linqiugui/Wall-climbing-robot-graduation-project-/爬壁机器人/奖状.jpg

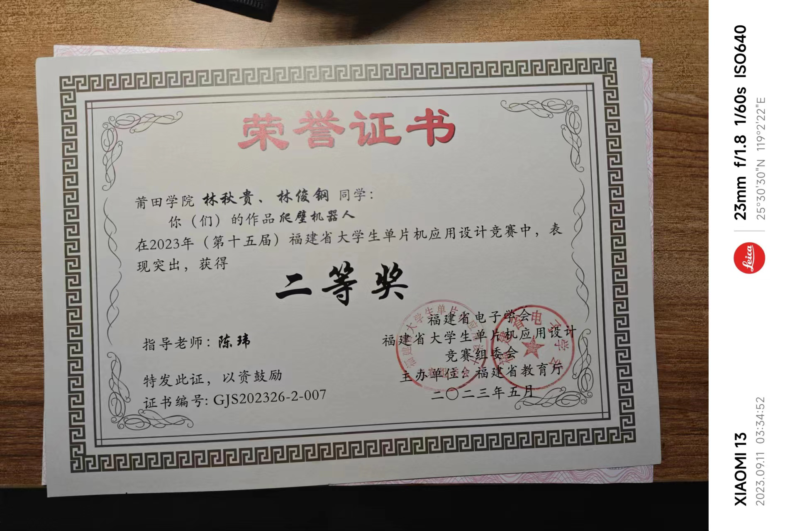
爬壁机器人/奖状.jpg
