linqiugui/Wall-climbing-robot-graduation-project-/爬壁机器人/3D建模/遥控器/10695037_10203569545496849_513445230_n.jpg

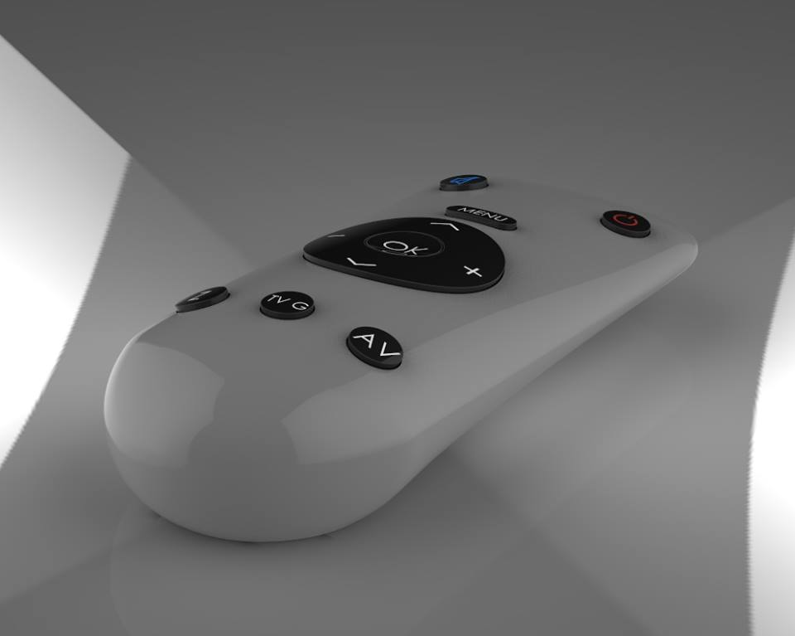
爬壁机器人/3D建模/遥控器/10695037_10203569545496849_513445230_n.jpg
