linqiugui/Wall-climbing-robot-graduation-project-/README.md

# Wall-climbing-robot-graduation-project-
爬壁机器人（毕设）:ht32、openmv h7、图像识别、多模式擦拭

作品视频：【2023福建省合泰杯-爬壁机器人】 https://www.bilibili.com/video/BV1Qh4y1n7L4/?share_source=copy_web&vd_source=07c3a1259b6d1e16c98340b300d98cfa
