linqiugui/Wall-climbing-robot-graduation-project-/爬壁机器人/ht32学习/复赛报告/林秋贵-莆田学院-爬壁机器人/林秋贵-莆田学院-爬壁机器人.pdf

(20230115089)：(爬壁机器人)

## 合泰杯单片机应用设计大赛复赛报告 爬壁机器人

学校：莆田学院 学院：机电与信息工程学院
指导老师：陈玮
参赛队员：林秋贵、林俊钢

### E-mail Address:481937578@qq.com 参赛编号:20230115089 使用 HT 单片机型 HT32F52352 日期:2023 年 4 月 25 日

摘要
爬壁机器人在垂直墙壁上攀爬并完成作业的自动化机器人。爬壁机器人又称为壁面移 动机器人，因为垂直壁面作业超出人的极限，因此在国外又称为极限作业机器人。爬壁机器 人必须具备吸附和移动两个基本功能，而常见吸附方式有负压吸附和磁吸附两种。 本作品爬壁机器人的应用场景为擦拭白板，在传统教学模式下，教师擦黑板过程繁琐， 严重影响课堂效率，这种方式会使得粉笔灰吸入教师学生的肺部，引发肺部健康问题。近年 来，因为白板使用时用专门的白板笔，笔杆干净整洁，没有粉渣，可选颜色多，所以黑板转 用白板情况越来越多。此外人为白板擦拭过程中有了一定的工作量，消耗了一部分的教学时 间。针对以上弊端设计了一款基 HT32F52352 的爬壁机器人，通过磁吸附的方式可以稳定地 吸附白板上进行白板擦拭和教学环境检测。
关键词：HT32F52352、爬壁、磁吸附、擦拭、环境检测 一、方案介绍：

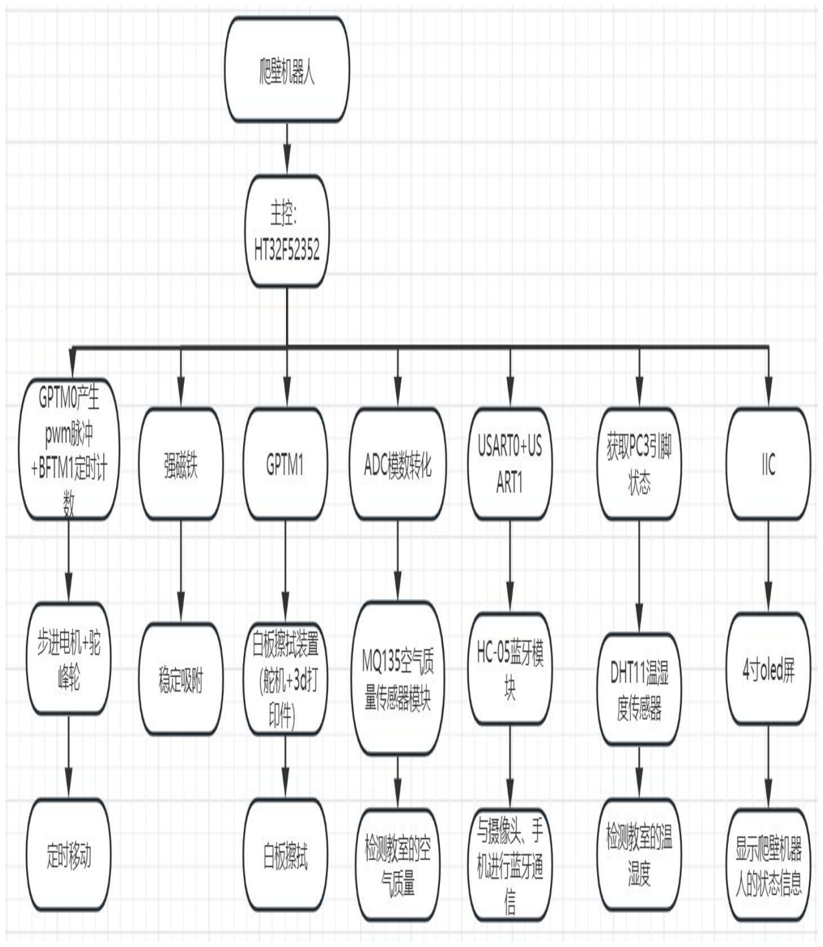
[picture p28: figure]

### 1.1 设计方案

本设计基于 HT32F52352 单片机。爬壁
机器人采用磁吸附的吸附结构置于底部，吸
附结构采用的是强磁铁，相较于电磁铁，强
磁铁磁力不受电压变化影响，使得爬壁机器
人吸力能稳定地吸附在白板上。爬壁机器人
的四个轮子采用驼峰轮，驼峰轮拥有极强的
摩擦力，能够保证爬壁机器人在白板面上移
动轮子不产生打滑。
爬壁机器人的两个 HC-05 蓝牙模块会分
别与来着手机遥控器和摄像头部分的蓝牙模
块进行互联通信。本作品将白板擦拭区域分为
6 个，适应更多不同擦拭区域需求。使用者可
以有三种擦拭模式选择，第一种是按键擦拭，
就是人为到爬壁机器人的屏幕板按下按键自
主控制爬壁机器人移动白板的对应区域进行
擦拭。第二种是无线擦拭，就是人为使用手机
控制爬壁机器人移动白板的某个区域进行擦
拭。第三种是智能擦拭，由摄像头 OPENMV
H7 智能识别白板需要擦拭的位置区域，用蓝
牙通信的方式传递给爬壁机器人，然后爬壁机
器人移动到指定位置进行擦拭，适应更多不同
擦拭方式需求。
在爬壁机器人一上电的瞬间，DHT11 温
湿度传感器和 MQ135 空气质量传感器模块也
会上电工作，检测环境中的温湿度、空气质量，
并将环境检测数据进行输出实时显示在爬壁
机器人的 OLED 屏幕上。

### 1.2 硬件方块结构图

图 1：硬件结构图

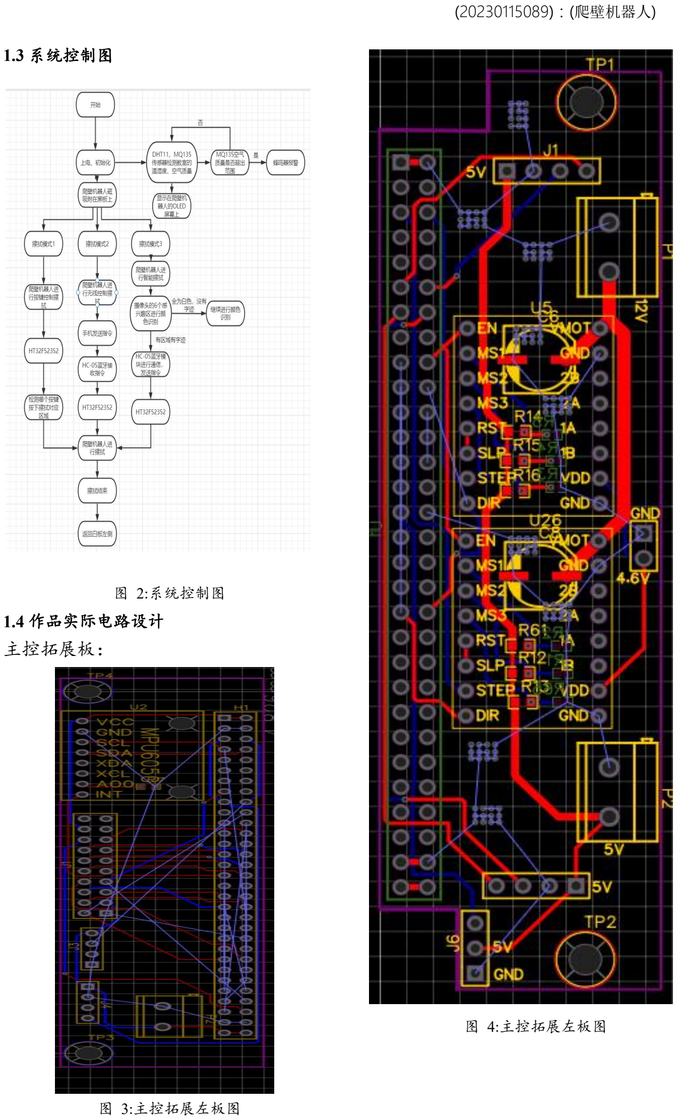
[picture p29: page 2]

### 1.3 系统控制图

图 2:系统控制图

### 1.4 作品实际电路设计

主控拓展板：

图 3:主控拓展左板图

图 4:主控拓展左板图

屏幕板：

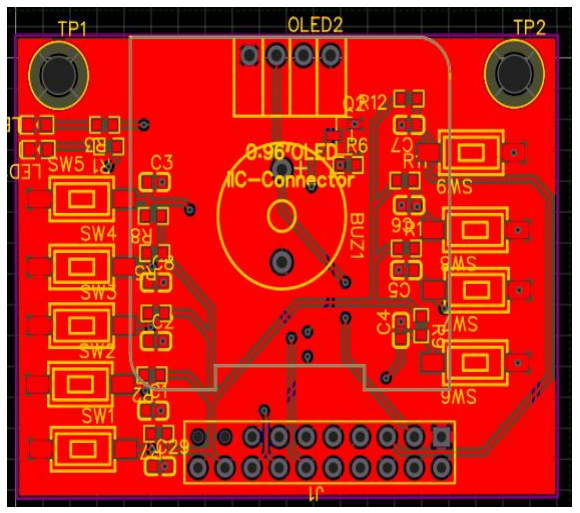
[picture p30: figure]

图 5:屏幕板
电源板：

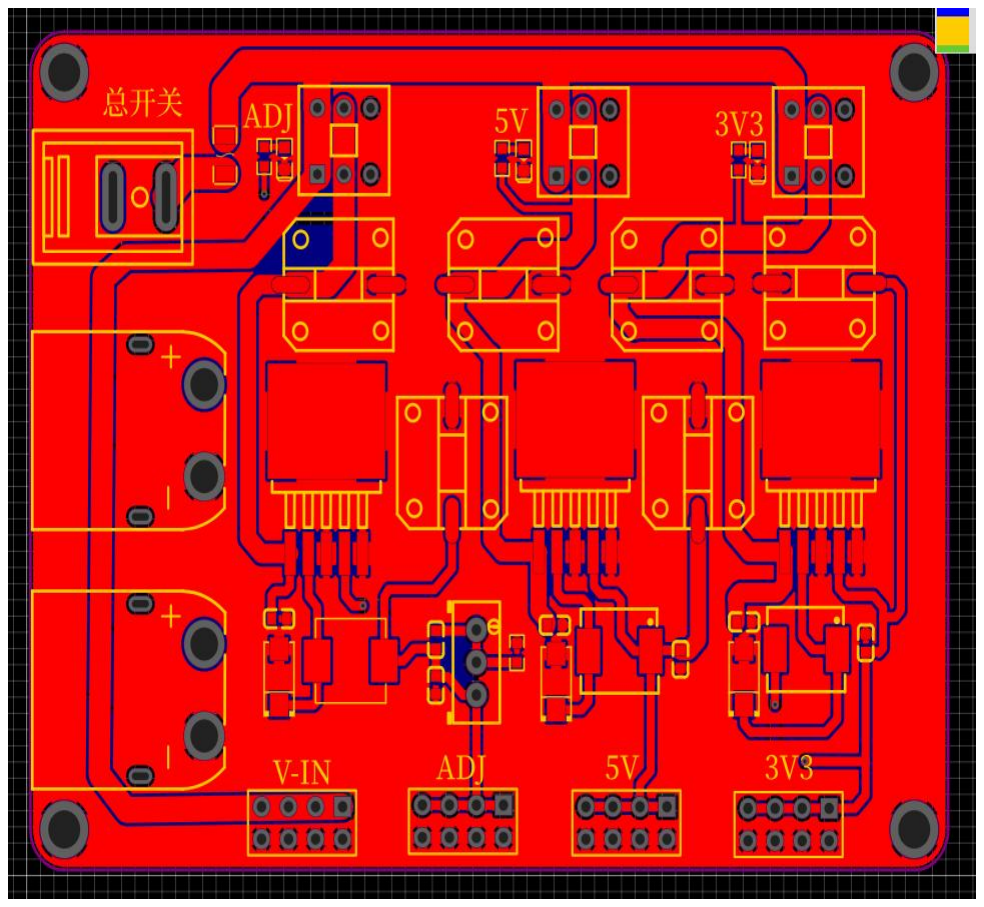
[picture p31: figure]

图 6:电源板
二、工作原理：
本作品基于 HT32F52352 单片机，分
为爬壁机器人部分，摄像头识别部分，手
机遥控器部分。

### 2.1 爬壁机器人部分原理

爬壁机器人主要由白板擦拭装置、强
磁铁、步进电机、驼峰轮、HC-05 蓝牙模
块、DHT11 温湿度传感器、MQ135 空气
质量传感器、oled 屏等组成。
该作品的爬壁机器人采用强磁铁的磁
吸附结构，使得爬壁机器人能吸附在磁性
白板上。爬壁机器人的移动由

### HT32F52352 单片机的通用定时器

（GPTM0）输出 PWM 波产生脉冲驱动步
进电机和基本功能定时器（BFTM1）定时
计数使得爬壁机器人能够进行定时移动。
爬壁机器人的白板擦拭装置由

### MG996-180 度舵机、自主设计的 3D 打印

件、棉布组成，通过 HT32F52352 单片机
的通用定时器（GPTM1）输出 PWM 波使
得舵机一直旋转，白板擦拭装置与白板字
迹产生摩擦,产生擦拭白板的效果。
爬壁机器人通过使用两个HC-05蓝牙
模块和 HT32F52352 单片机的两个串口

### （USART0 和 USART1）与摄像头部分、

手机遥控器部分进行无线蓝牙通信。
该爬壁机器人使用 DHT11 温湿度传
感器模块运用 HT32F52352 的引脚读取电
平信号由 HT32F52352 处理成数据显示在
爬壁机器人的 OLED 屏幕上。该爬壁机器
人使用 MQ-135 空气质量传感器模块运用

### HT32F52352 的 ADC 数模转化，由

HT32F52352 处理成数据显示在爬壁机器
人的 OLED 屏幕上，实时检测环境中的空
气质量、温湿度。

### 2.2 摄像头识别部分原理

摄像头部分主要由摄像头 OPNEMV
H7、HC-05 蓝牙模块、电源板组成。用支
架将摄像头部分放于离白板正前方合适的
位置，便于将整个白板都能进入摄像头的
识别画面中，然后将白板画面分为 6 个感
兴趣区，同时对 6 个感兴趣区进行颜色识
别，当识别有字迹时，摄像头将把有字迹
的感兴趣区的指令通过HC-05蓝牙模块发
给爬壁机器人，例如区域 1 识别到需要擦
拭，摄像头就发出字符‘1’指令给爬壁机
器人，其他区域以此类推。

### 2.3 手机遥控部分原理

手机遥控部分由手机下载蓝牙串口
APP，与爬壁机器人的 HC-05 蓝牙模块进
行互连，通过发送指令无线遥控控制爬壁
机器人对某个区域继续擦拭。

### 2.4 开发内容范围

本作品除部分代码外，其他开发内容
均有参赛者自主开发。
参考代码来源：

### https://blog.csdn.net/boybs/article/details/12446

7960
三、测试方法：

### 3.1 擦拭方法

爬壁机器人分为两部分测试，一部分
为擦拭功能测试，另一部分为摄像头识别
测试。
擦拭功能测试为爬壁机器人是否能够
将对应区域的字迹擦拭干净，擦拭完后能
否移动会白板左侧中央。

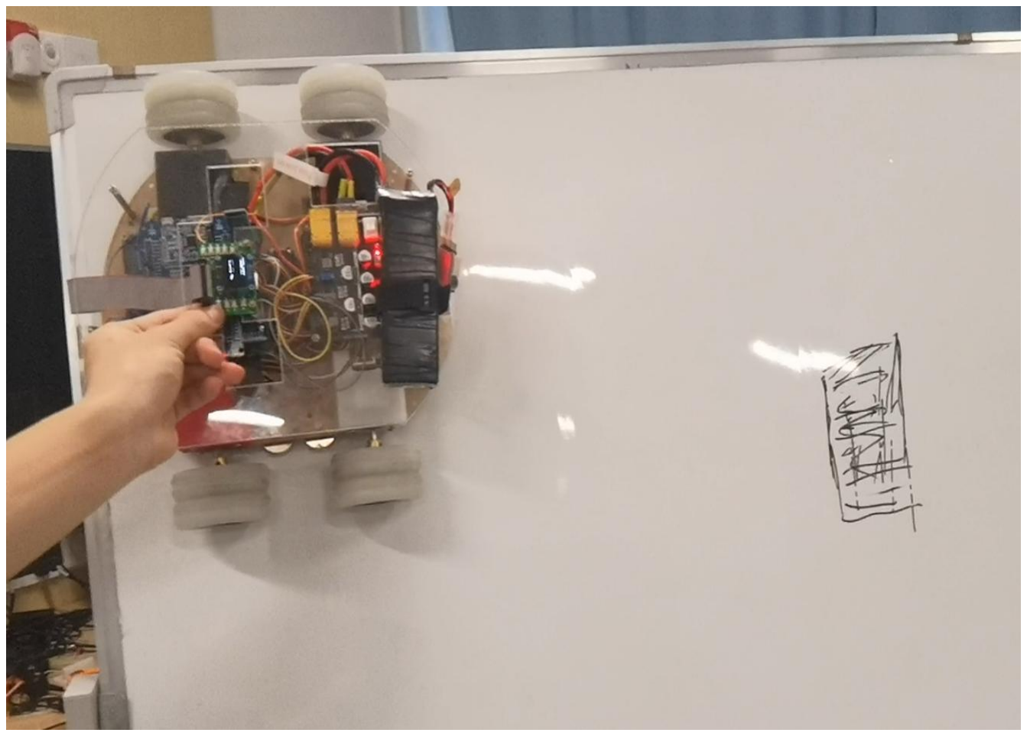
[picture p32: figure]

图 7:擦拭开始前

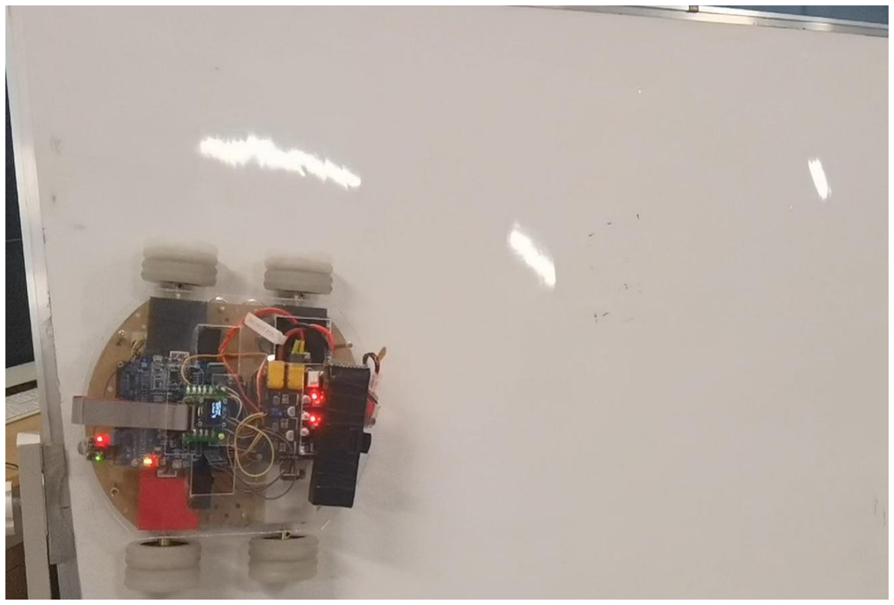
[picture p33: figure]

图 8:字迹擦拭干净，并且回到白板左侧中央
摄像头识别测试为摄像头能否识别出
有字迹的区域，且识别后能否把擦拭指令
发送给爬壁机器人。

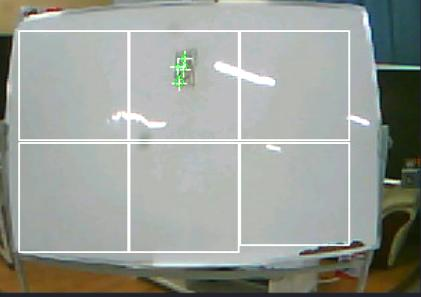
[picture p34: figure]

图 9:摄像头识别出区域 2 字迹

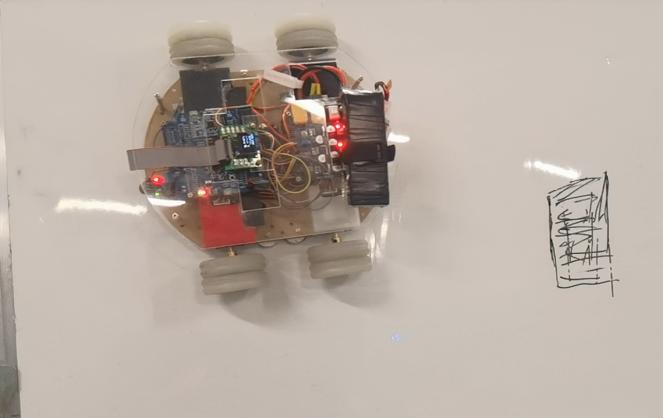
[picture p35: figure]

图 10:爬壁机器人接收到指令，进行擦拭

### 3.2 测试的环境与条件

本作品是基于 HT32F52352 单片机作
为主控芯片。爬壁机器人可以通过三种模
式进行白板擦拭，并且环境中的温湿度、
空气质量实时显示在 oled 屏上。

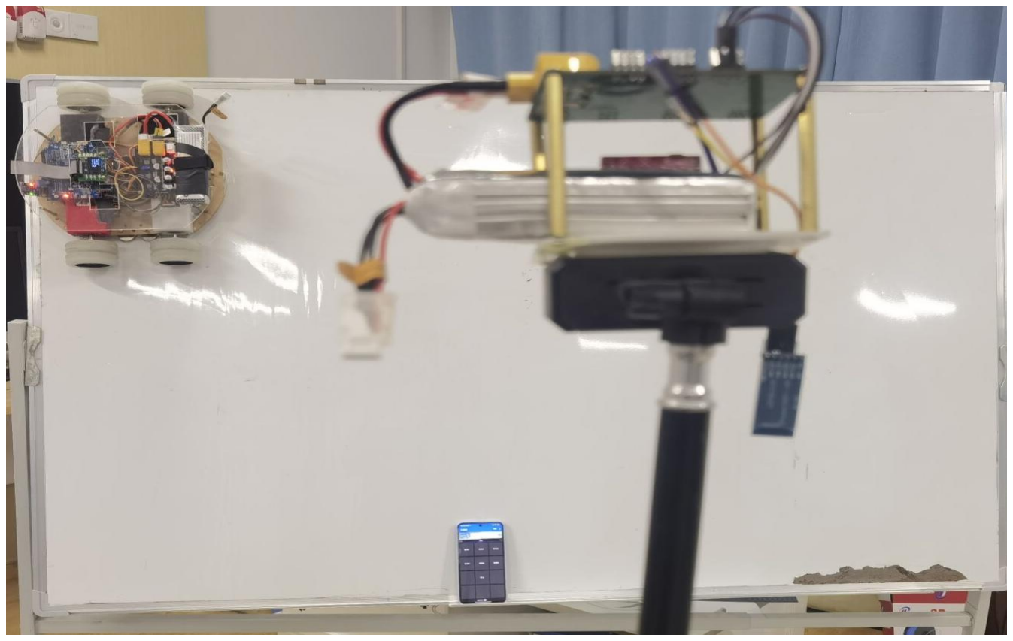
[picture p36: figure]

图 11：整体图

### 3.3 测试结果

本作品各功能均能正常的使用，爬壁
机器人部分和摄像头识别部分、手机遥控
器部分均可通信。但由于经费有限，作品
所使用白板表面不平（中间凹，两侧凸）、
某些区域有凹陷等问题，导致在某个区域
进行擦拭时爬壁机器人移动路线出现偏移、
无法回到白板左侧中央的可能，不影响产
品的擦拭功能正常使用，但测试实验均能
证明模块程序的可行性。
表 1：测试统计表

四、作品结论：

### 4.1 完成情况与应用潜力

作品已完成基本的所有预实现功能，
能够检测环境中的温湿度、空气质量， 较
高概率实现擦拭白板。作品准确率较高，
具有较好的实用价值。该作品能应用于教
学、办公领域的白板擦拭，同类产品较少，
可以填补部分的市场空缺。

### 4.1 未来改进空间

本作品未来可以继续改进，可加入陀

区域 | 测试次数 | 成功次数 | 成功 率
区域 1 | 20 | 19 | 95%
区域 2 | 20 | 18 | 90%
区域 3 | 20 | 12 | 60%
区域 4 | 20 | 18 | 90%
区域 5 | 20 | 16 | 80%
区域 6 | 20 | 14 | 70%

(20230115089)：(爬壁机器人) 螺仪等传感器模块，实现爬壁机器人定向 移动，不受白板表面影响。当经费满足条 件时更将强磁铁的吸附结构改为负压吸附 结构，减少擦拭过程中噪音的产生。 五、参考文献： 【1】吕晓彬，王志凌，梁贵龙，等．基于 STM32 控制器的智能黑板擦系统设计 [J]．盐城工学院学报(自然科学版)，2018， 31（2）：36－37
