linqiugui/Wall-climbing-robot-graduation-project-/爬壁机器人/3D建模/三角架/Phone Tripod.PNG

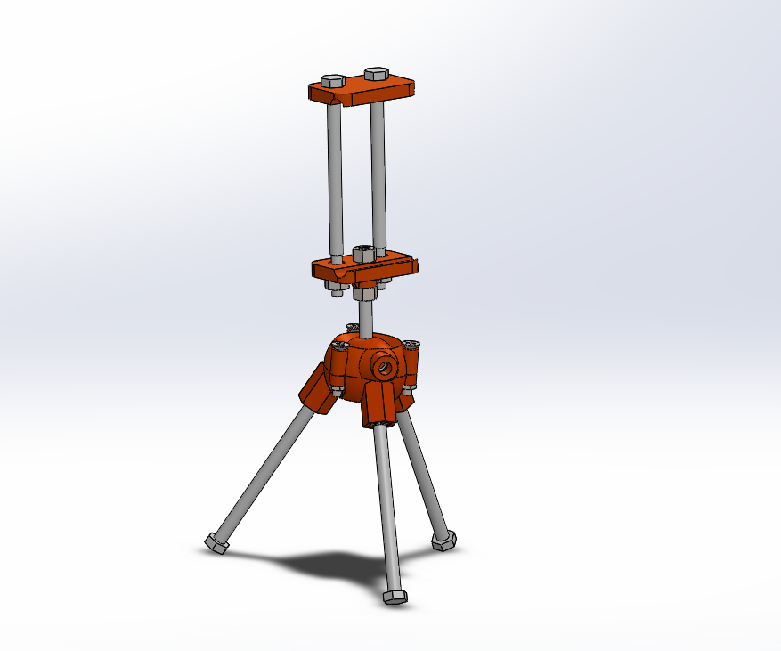
爬壁机器人/3D建模/三角架/Phone Tripod.PNG
