linqiugui/Wall-climbing-robot-graduation-project-/爬壁机器人/3D建模/遥控器/10656420_10203569522256268_1597879605_n.jpg

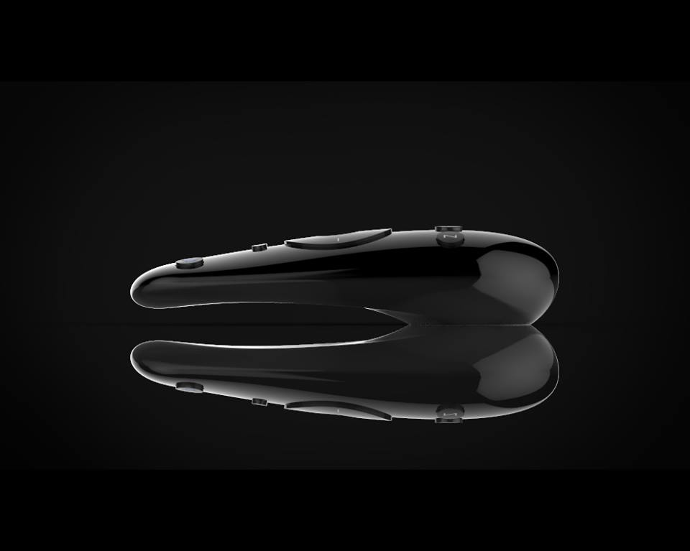
爬壁机器人/3D建模/遥控器/10656420_10203569522256268_1597879605_n.jpg
