linqiugui/Wall-climbing-robot-graduation-project-/爬壁机器人/3D建模/遥控器/10656624_10203569522416272_220578106_n.jpg

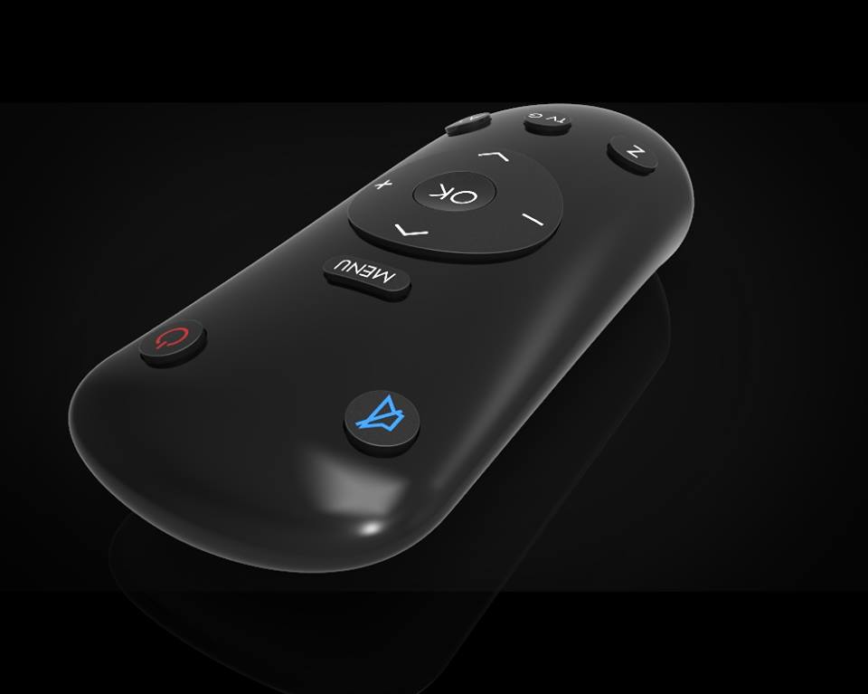
爬壁机器人/3D建模/遥控器/10656624_10203569522416272_220578106_n.jpg
