linqiugui/Wall-climbing-robot-graduation-project-/爬壁机器人/3D建模/遥控器/10668206_10203569545416847_239513707_n.jpg

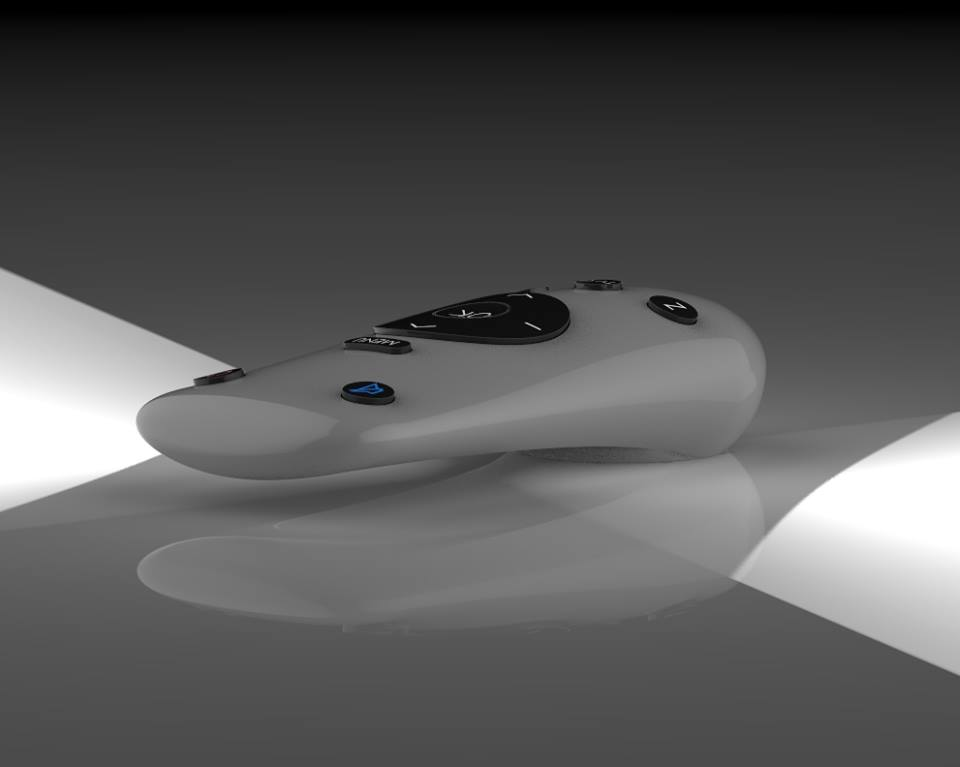
爬壁机器人/3D建模/遥控器/10668206_10203569545416847_239513707_n.jpg
