linqiugui/Wall-climbing-robot-graduation-project-/爬壁机器人/3D建模/遥控器/10682006_10203569522296269_1531062614_n.jpg

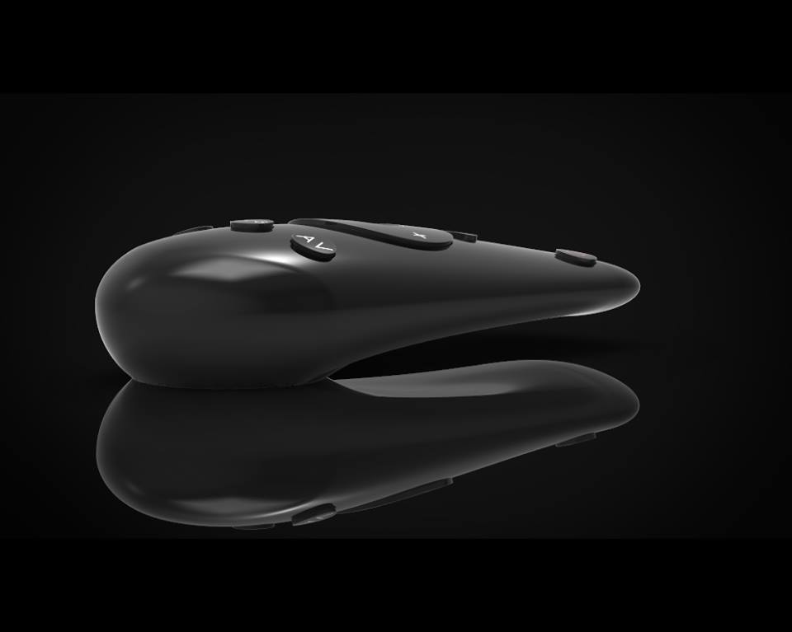
爬壁机器人/3D建模/遥控器/10682006_10203569522296269_1531062614_n.jpg
