linqiugui/Wall-climbing-robot-graduation-project-/爬壁机器人/3D建模/遥控器/10685057_10203569545456848_659820828_n.jpg

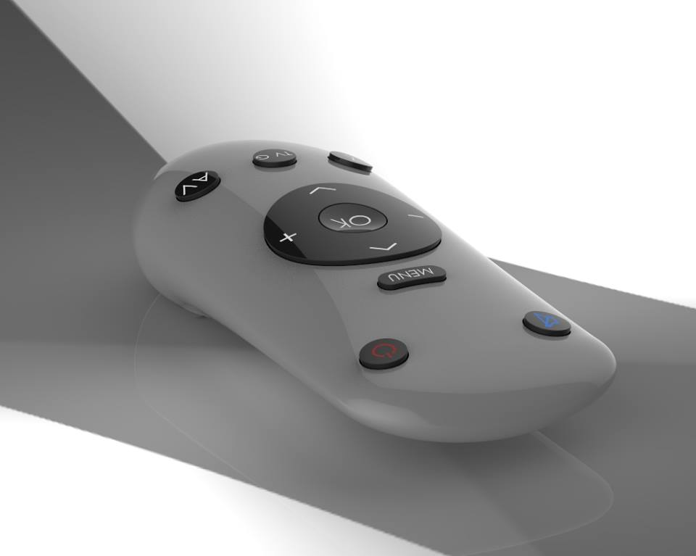
爬壁机器人/3D建模/遥控器/10685057_10203569545456848_659820828_n.jpg
