linqiugui/Wall-climbing-robot-graduation-project-/爬壁机器人/3D建模/遥控器/10695032_10203569522216267_47995985_n (1).jpg

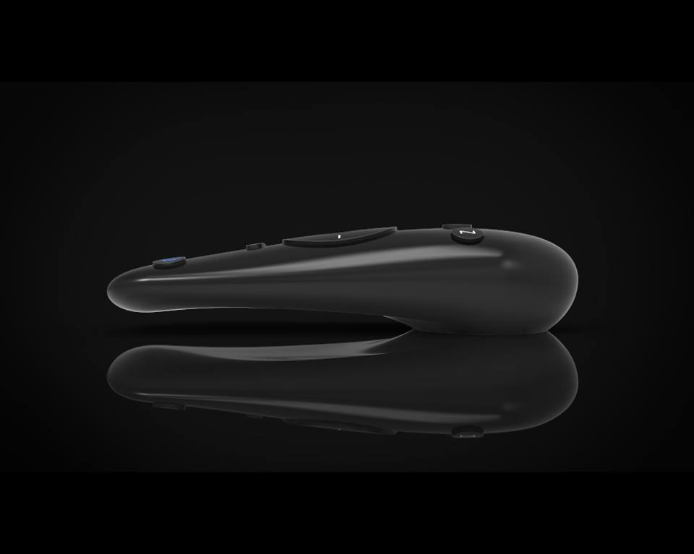
爬壁机器人/3D建模/遥控器/10695032_10203569522216267_47995985_n (1).jpg
