linqiugui/Wall-climbing-robot-graduation-project-/爬壁机器人/3D建模/遥控器/10704995_10203569522176266_1851552461_n.jpg

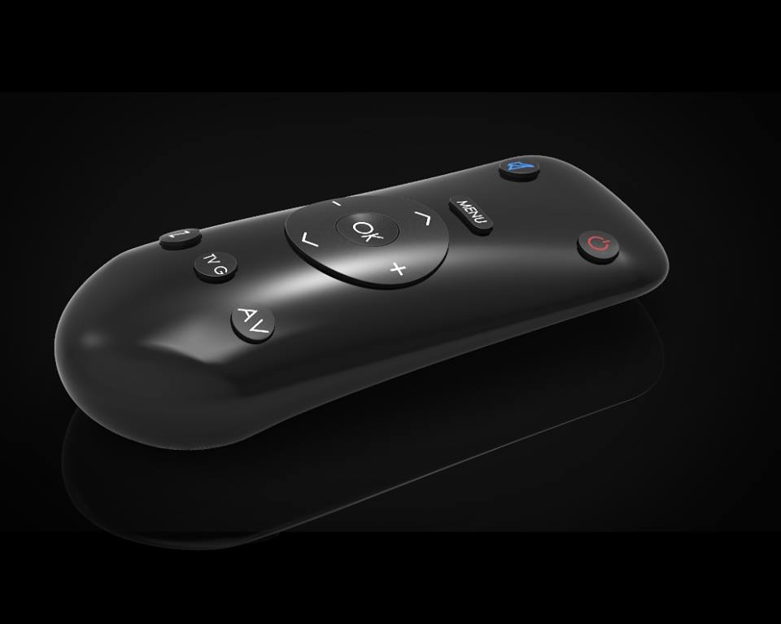
爬壁机器人/3D建模/遥控器/10704995_10203569522176266_1851552461_n.jpg
