linqiugui/Wall-climbing-robot-graduation-project-/爬壁机器人/3D建模/黑板擦小车/A1 麦克纳姆轮（全向轮）四驱agv小车底盘/A.JPG

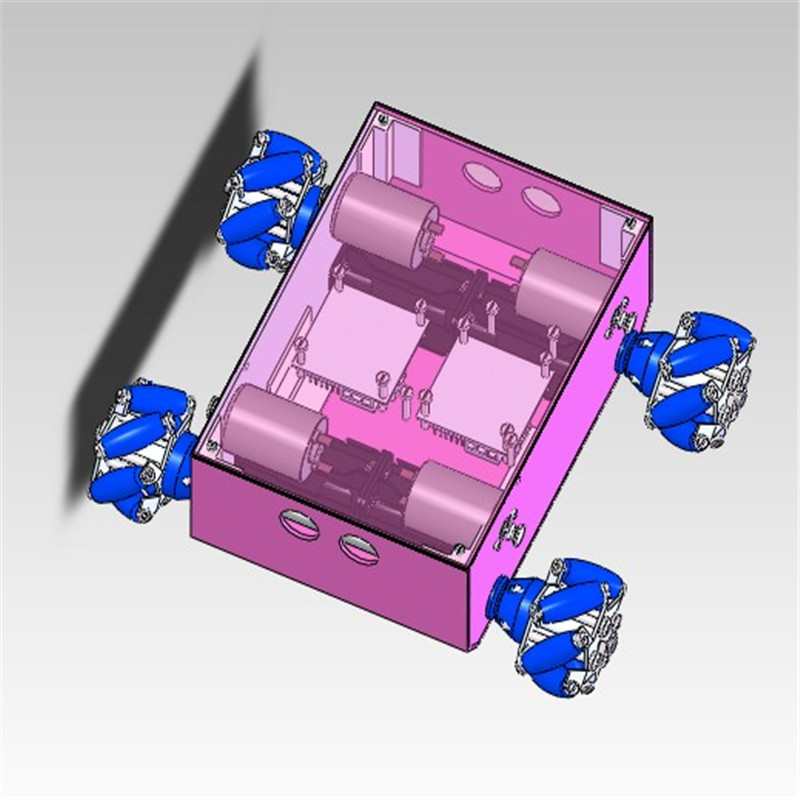
爬壁机器人/3D建模/黑板擦小车/A1 麦克纳姆轮（全向轮）四驱agv小车底盘/A.JPG
