linqiugui/Wall-climbing-robot-graduation-project-/爬壁机器人/ht32学习/林秋贵-莆田学院-爬壁机器人/林秋贵-莆田学院-爬壁机器人-初赛报名简表.xls

2023年第十五届福建省大学生合泰杯单片机应用设计竞赛报名简表
序号 | 参赛编号 | 项目名称 | 指导老师 | 学生身份（本科生或研究生） | 成员一 (队长) | 成员二 | 成员三 | 成员四 | 所在学校 | 联系电话（队长） | QQ
不填 | 不填 | 爬壁机器人 | 陈玮 | 本科生 | 林秋贵 | 林俊钢 |  |  | 莆田学院 | 15059693812 | 481937578
