linqiugui/Wall-climbing-robot-graduation-project-/爬壁机器人/3D建模/三角架/Telefon Bipod.SLDASM

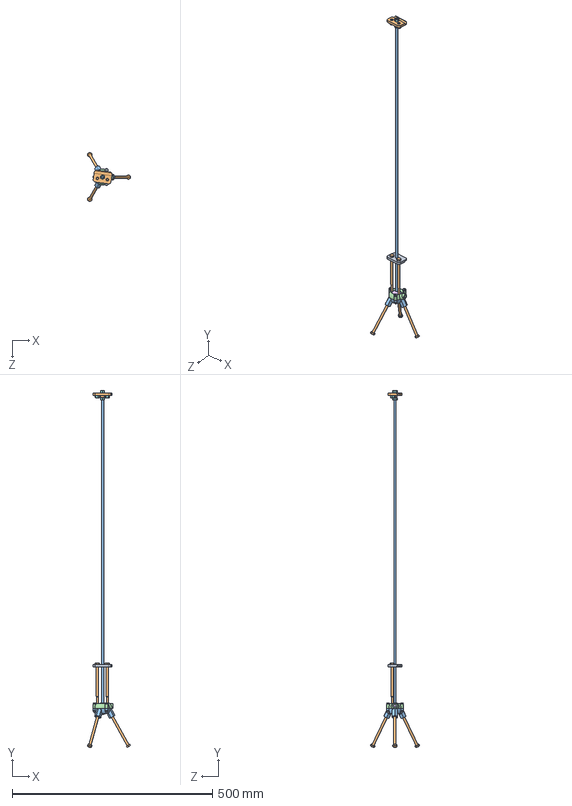
[picture p46: CAD file, 2026-02-27]
爬壁机器人/3D建模/三角架/Telefon Bipod.SLDASM
107.5 x 892.0 x 123.6 mm
hex nut with 1.5d height-2_din x 3
bilya
hex thin nut chamfered gradeab_din x 3
hex nut gradec_din x 4
countersunk flat head cross recess screw_din x 3
M6x100 Civata x 5
M6x60 Civata
