linqiugui/Wall-climbing-robot-graduation-project-/爬壁机器人/3D建模/黑板擦小车/A1 麦克纳姆轮（全向轮）四驱agv小车底盘/麦克纳姆轮（全向轮）四驱agv小车底盘/麦克纳姆轮（全向轮）四驱agv小车底盘/总装配图.SLDASM

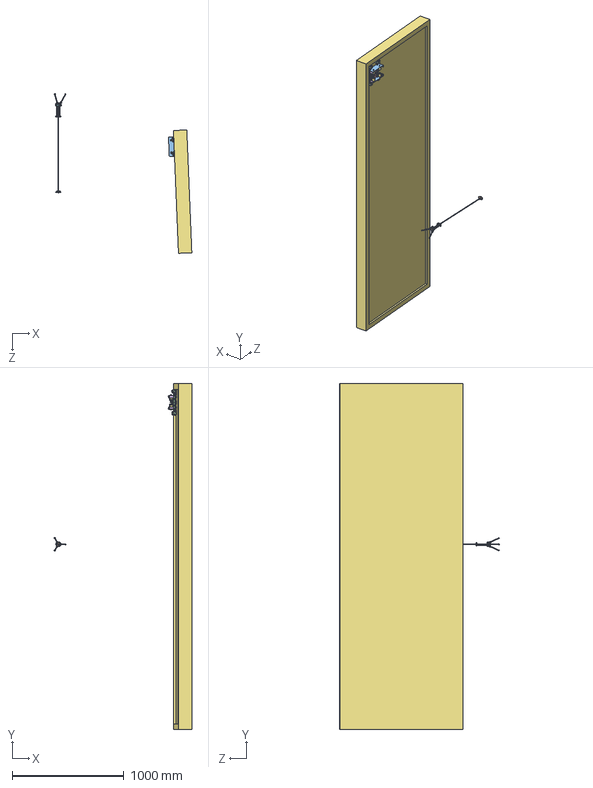
[picture p47: CAD file, 2026-02-27]
爬壁机器人/3D建模/黑板擦小车/A1 麦克纳姆轮（全向轮）四驱agv小车底盘/麦克纳姆轮（全向轮）四驱agv小车底盘/麦克纳姆轮（全向轮）四驱agv小车底盘/总装配图.SLDASM
1234.4 x 3102.2 x 1431.5 mm
Roller2 x 24
Mariposa 1 x 4
Mariposa 2 x 4
nucleo con prisionero x 4
pan head cross recess screw_iso(ISO 7045 - M4 x 40 - Z --- 40N) x 16
slotted cheese head screw_iso(ISO 1207 - M3 x 30 --- 30N) x 24
hex thin nut chamfered gradeab_iso(Hexagon Thin Nut ISO - 4035 - M3 - N) x 24
Pieza lateral x 2
Portapilas x 4
L298N x 2
Refuerzo chasis x 6
Motor impresora x 4
slotted cheese head screw_iso(ISO 1207 - M2 x 5 --- 5N) x 8
slotted cheese head screw_iso(ISO 1207 - M3 x 20 --- 20N) x 8
Eje varilla roscada M6 x 2
slotted cheese head screw_iso(ISO 1207 - M3 x 16 --- 16N) x 4
slotted cheese head screw_iso(ISO 1207 - M2 x 10 --- 10N) x 4
Casquillo ruedas x 4
hex thin nut chamfered gradeab_iso(Hexagon Thin Nut ISO - 4035 - M6 - N) x 4
黑板
hex nut with 1.5d height-2_din x 3
bilya
hex thin nut chamfered gradeab_din x 3
hex nut gradec_din x 4
countersunk flat head cross recess screw_din x 3
M6x100 Civata x 5
M6x60 Civata
