linqiugui/Wall-climbing-robot-graduation-project-/爬壁机器人/3D建模/三角架/Phone Tripod/3.SLDPRT

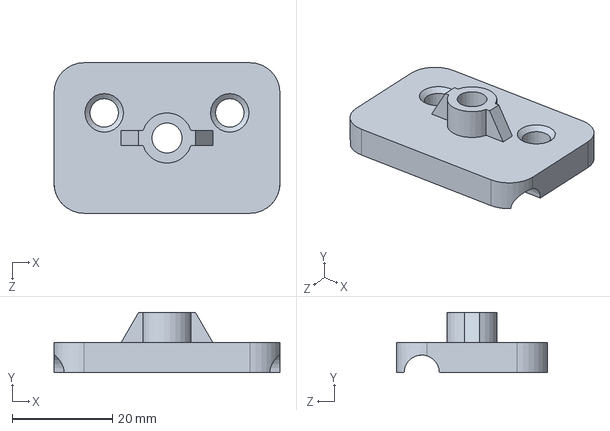
[picture p48: CAD file, 2026-02-27]
爬壁机器人/3D建模/三角架/Phone Tripod/3.SLDPRT
45.0 x 12.0 x 30.0 mm
