linqiugui/Wall-climbing-robot-graduation-project-/爬壁机器人/3D建模/遥控器/Kumanda2.STEP

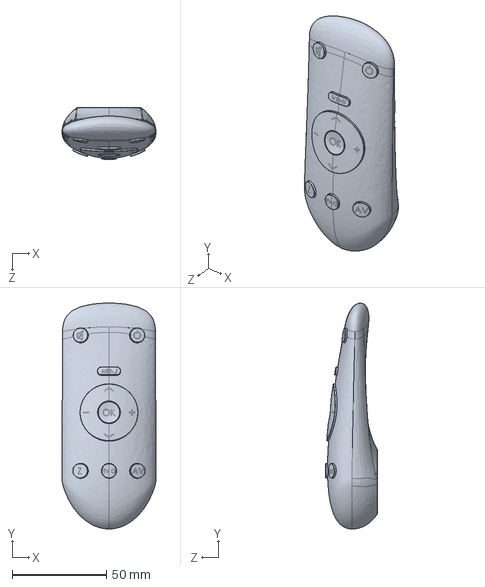
[picture p49: CAD file, 2026-02-27]
爬壁机器人/3D建模/遥控器/Kumanda2.STEP
50.0 x 120.2 x 27.6 mm
