linqiugui/Wall-climbing-robot-graduation-project-/爬壁机器人/3D建模/黑板.SLDPRT

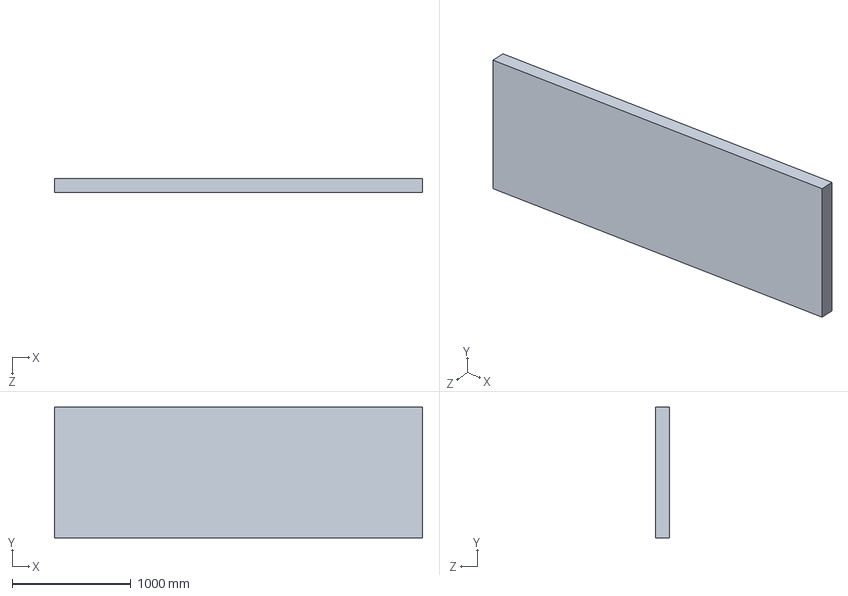
[picture p50: CAD file, 2026-02-27]
爬壁机器人/3D建模/黑板.SLDPRT
3102.2 x 1102.2 x 120.0 mm
