linqiugui/Wall-climbing-robot-graduation-project-/爬壁机器人/3D建模/三角架/Phone Tripod/2.SLDPRT

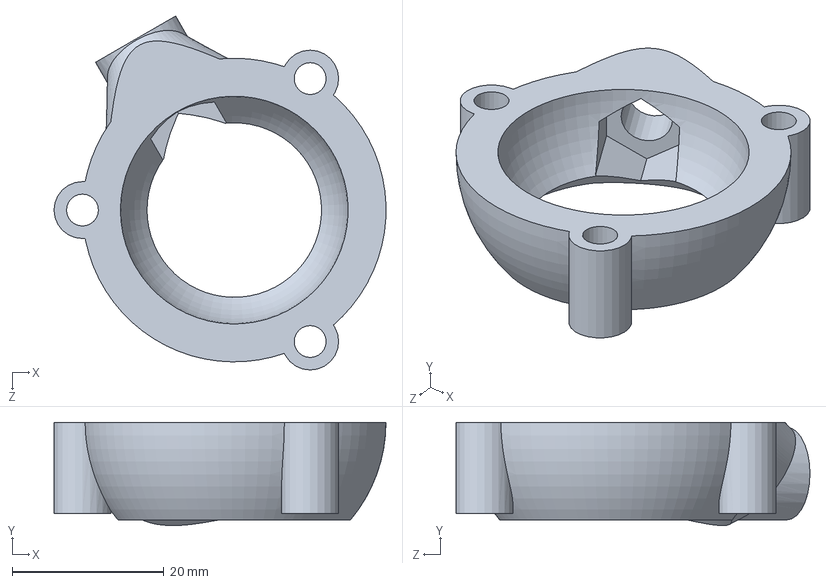
[picture p51: CAD file, 2026-02-27]
爬壁机器人/3D建模/三角架/Phone Tripod/2.SLDPRT
43.7 x 13.6 x 46.6 mm
