linqiugui/Wall-climbing-robot-graduation-project-/爬壁机器人/3D建模/三角架/Phone Tripod/bilya.SLDPRT

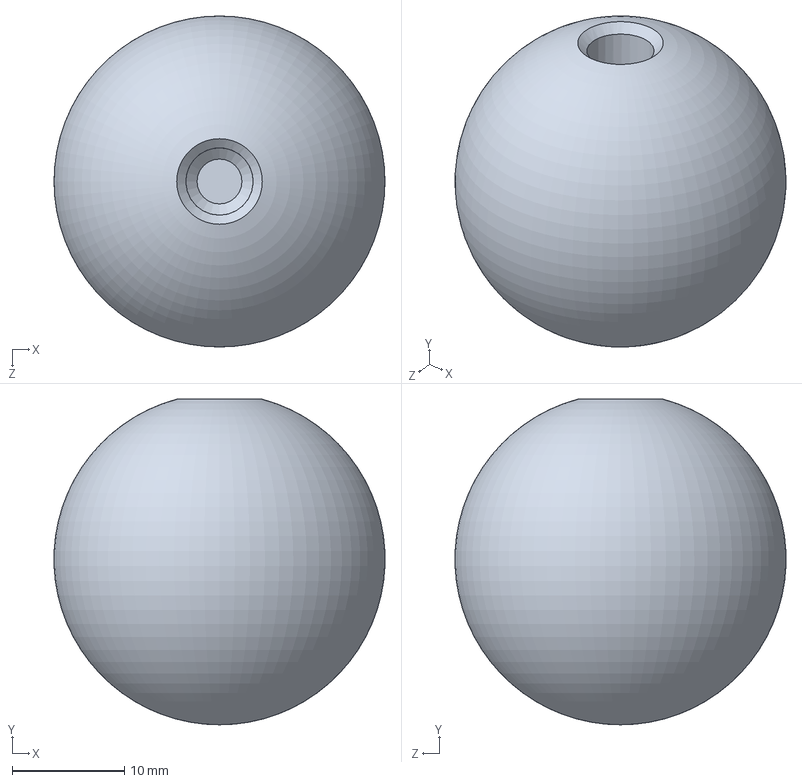
[picture p52: CAD file, 2026-02-27]
爬壁机器人/3D建模/三角架/Phone Tripod/bilya.SLDPRT
29.5 x 29.0 x 29.5 mm
