linqiugui/Wall-climbing-robot-graduation-project-/爬壁机器人/3D建模/三角架/Phone Tripod/4.SLDPRT

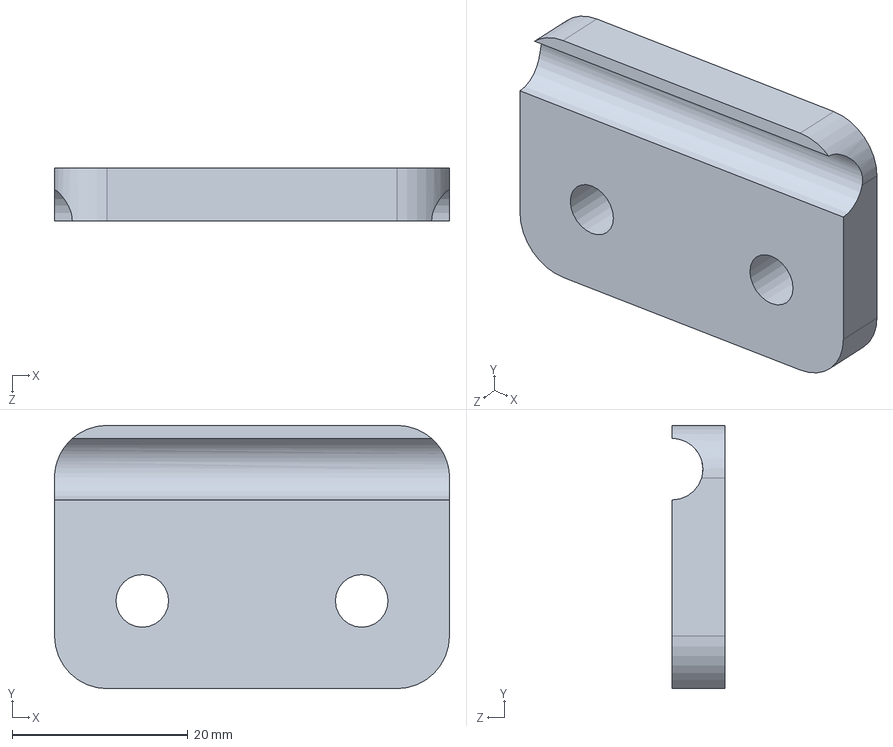
[picture p53: CAD file, 2026-02-27]
爬壁机器人/3D建模/三角架/Phone Tripod/4.SLDPRT
45.0 x 30.0 x 6.00 mm
