linqiugui/Wall-climbing-robot-graduation-project-/爬壁机器人/3D建模/三角架/Phone Tripod/1.SLDPRT

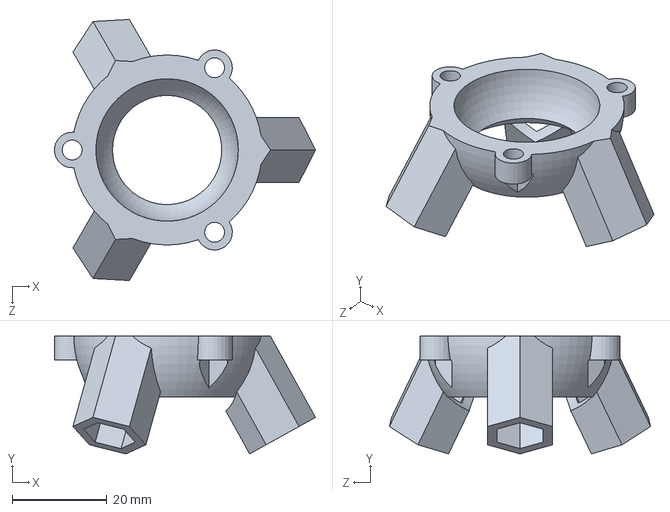
[picture p54: CAD file, 2026-02-27]
爬壁机器人/3D建模/三角架/Phone Tripod/1.SLDPRT
55.0 x 24.8 x 55.0 mm
