linqiugui/Wall-climbing-robot-graduation-project-/(list of files, cad)

Other CAD files:
爬壁机器人/3D建模/黑板擦小车/A1 麦克纳姆轮（全向轮）四驱agv小车底盘/麦克纳姆轮（全向轮）四驱agv小车底盘/麦克纳姆轮（全向轮）四驱agv小车底盘/Mecanum Terminada-1.sldasm
爬壁机器人/3D建模/黑板擦小车/A1 麦克纳姆轮（全向轮）四驱agv小车底盘/麦克纳姆轮（全向轮）四驱agv小车底盘/麦克纳姆轮（全向轮）四驱agv小车底盘/Mecanum Terminada.sldasm
爬壁机器人/3D建模/黑板擦小车/A1 麦克纳姆轮（全向轮）四驱agv小车底盘/麦克纳姆轮（全向轮）四驱agv小车底盘/麦克纳姆轮（全向轮）四驱agv小车底盘/Mecanum Terminada-2.sldasm
爬壁机器人/3D建模/黑板擦小车/A1 麦克纳姆轮（全向轮）四驱agv小车底盘/麦克纳姆轮（全向轮）四驱agv小车底盘/麦克纳姆轮（全向轮）四驱agv小车底盘/Mecanum Terminada-3.sldasm
爬壁机器人/3D建模/黑板擦小车/A1 麦克纳姆轮（全向轮）四驱agv小车底盘/麦克纳姆轮（全向轮）四驱agv小车底盘/麦克纳姆轮（全向轮）四驱agv小车底盘/Eje varilla roscada M6.sldprt
爬壁机器人/3D建模/黑板擦小车/A1 麦克纳姆轮（全向轮）四驱agv小车底盘/麦克纳姆轮（全向轮）四驱agv小车底盘/麦克纳姆轮（全向轮）四驱agv小车底盘/Pieza lateral.sldprt
爬壁机器人/3D建模/黑板擦小车/A1 麦克纳姆轮（全向轮）四驱agv小车底盘/麦克纳姆轮（全向轮）四驱agv小车底盘/麦克纳姆轮（全向轮）四驱agv小车底盘/Mariposa 1.sldprt
爬壁机器人/3D建模/黑板擦小车/A1 麦克纳姆轮（全向轮）四驱agv小车底盘/麦克纳姆轮（全向轮）四驱agv小车底盘/麦克纳姆轮（全向轮）四驱agv小车底盘/nucleo con prisionero.sldprt
爬壁机器人/3D建模/黑板擦小车/A1 麦克纳姆轮（全向轮）四驱agv小车底盘/麦克纳姆轮（全向轮）四驱agv小车底盘/麦克纳姆轮（全向轮）四驱agv小车底盘/Bluetooth.sldprt
爬壁机器人/3D建模/黑板擦小车/A1 麦克纳姆轮（全向轮）四驱agv小车底盘/麦克纳姆轮（全向轮）四驱agv小车底盘/麦克纳姆轮（全向轮）四驱agv小车底盘/Motor impresora.sldprt
爬壁机器人/3D建模/黑板擦小车/A1 麦克纳姆轮（全向轮）四驱agv小车底盘/麦克纳姆轮（全向轮）四驱agv小车底盘/麦克纳姆轮（全向轮）四驱agv小车底盘/Tpadera.sldprt
爬壁机器人/3D建模/黑板擦小车/A1 麦克纳姆轮（全向轮）四驱agv小车底盘/麦克纳姆轮（全向轮）四驱agv小车底盘/麦克纳姆轮（全向轮）四驱agv小车底盘/L298N.sldprt
爬壁机器人/3D建模/黑板擦小车/A1 麦克纳姆轮（全向轮）四驱agv小车底盘/麦克纳姆轮（全向轮）四驱agv小车底盘/麦克纳姆轮（全向轮）四驱agv小车底盘/Mariposa 2.sldprt
爬壁机器人/3D建模/黑板擦小车/A1 麦克纳姆轮（全向轮）四驱agv小车底盘/麦克纳姆轮（全向轮）四驱agv小车底盘/麦克纳姆轮（全向轮）四驱agv小车底盘/Casquillo ruedas.sldprt
爬壁机器人/3D建模/黑板擦小车/A1 麦克纳姆轮（全向轮）四驱agv小车底盘/麦克纳姆轮（全向轮）四驱agv小车底盘/麦克纳姆轮（全向轮）四驱agv小车底盘/Roller2.sldprt
爬壁机器人/3D建模/黑板擦小车/A1 麦克纳姆轮（全向轮）四驱agv小车底盘/麦克纳姆轮（全向轮）四驱agv小车底盘/麦克纳姆轮（全向轮）四驱agv小车底盘/Chasis aluminio.sldprt
爬壁机器人/3D建模/黑板擦小车/A1 麦克纳姆轮（全向轮）四驱agv小车底盘/麦克纳姆轮（全向轮）四驱agv小车底盘/麦克纳姆轮（全向轮）四驱agv小车底盘/Portapilas.sldprt
爬壁机器人/3D建模/黑板擦小车/A1 麦克纳姆轮（全向轮）四驱agv小车底盘/麦克纳姆轮（全向轮）四驱agv小车底盘/麦克纳姆轮（全向轮）四驱agv小车底盘/Refuerzo chasis.sldprt
爬壁机器人/3D建模/三角架/Phone Tripod/M6x100 Civata.SLDPRT
爬壁机器人/3D建模/三角架/Phone Tripod/M6x60 Civata.SLDPRT
爬壁机器人/3D建模/遥控器/Kumanda2.IGS
爬壁机器人/3D建模/遥控器/Kumanda2.STL
爬壁机器人/3D建模/黑板擦小车/A1 麦克纳姆轮（全向轮）四驱agv小车底盘/麦克纳姆轮（全向轮）四驱agv小车底盘/麦克纳姆轮（全向轮）四驱agv小车底盘/hex thin nut chamfered gradeab_iso(Hexagon Thin Nut ISO - 4035 - M3 - N).sldprt
爬壁机器人/3D建模/黑板擦小车/A1 麦克纳姆轮（全向轮）四驱agv小车底盘/麦克纳姆轮（全向轮）四驱agv小车底盘/麦克纳姆轮（全向轮）四驱agv小车底盘/hex thin nut chamfered gradeab_iso(Hexagon Thin Nut ISO - 4035 - M6 - N).sldprt
爬壁机器人/3D建模/黑板擦小车/A1 麦克纳姆轮（全向轮）四驱agv小车底盘/麦克纳姆轮（全向轮）四驱agv小车底盘/麦克纳姆轮（全向轮）四驱agv小车底盘/pan head cross recess screw_iso(ISO 7045 - M4 x 40 - Z --- 40N).sldprt
爬壁机器人/3D建模/黑板擦小车/A1 麦克纳姆轮（全向轮）四驱agv小车底盘/麦克纳姆轮（全向轮）四驱agv小车底盘/麦克纳姆轮（全向轮）四驱agv小车底盘/slotted cheese head screw_iso(ISO 1207 - M2 x 10 --- 10N).sldprt
爬壁机器人/3D建模/黑板擦小车/A1 麦克纳姆轮（全向轮）四驱agv小车底盘/麦克纳姆轮（全向轮）四驱agv小车底盘/麦克纳姆轮（全向轮）四驱agv小车底盘/slotted cheese head screw_iso(ISO 1207 - M2 x 5 --- 5N).sldprt
爬壁机器人/3D建模/黑板擦小车/A1 麦克纳姆轮（全向轮）四驱agv小车底盘/麦克纳姆轮（全向轮）四驱agv小车底盘/麦克纳姆轮（全向轮）四驱agv小车底盘/slotted cheese head screw_iso(ISO 1207 - M3 x 16 --- 16N).sldprt
爬壁机器人/3D建模/黑板擦小车/A1 麦克纳姆轮（全向轮）四驱agv小车底盘/麦克纳姆轮（全向轮）四驱agv小车底盘/麦克纳姆轮（全向轮）四驱agv小车底盘/slotted cheese head screw_iso(ISO 1207 - M3 x 20 --- 20N).sldprt
爬壁机器人/3D建模/黑板擦小车/A1 麦克纳姆轮（全向轮）四驱agv小车底盘/麦克纳姆轮（全向轮）四驱agv小车底盘/麦克纳姆轮（全向轮）四驱agv小车底盘/slotted cheese head screw_iso(ISO 1207 - M3 x 30 --- 30N).sldprt
