linqiugui/Wall-climbing-robot-graduation-project-/爬壁机器人/ht32学习/练习代码/htKEY中断/project/main.c

////-----------------------------------------------------------------------------
//#include "ht32.h"

//#include "UART.h"

//void delay(){

//	unsigned int i,j;
//	for(i=0;i<1000;i++){
//	
//	for(j=0;j<1000;j++){
//	 }	
//	}

//}

////-----------------------------------------------------------------------------
//int main(void)
//{
//	GPIO_Configuration();
//	USARTx_Init();
//  while (1)
//  {
//	  GPIO_ClearOutBits(OUT_PC14_GPIO_PORT, OUT_PC14_GPIO_PIN);//点灯
//	  delay();//延时
//	  
//	  GPIO_SetOutBits(OUT_PC14_GPIO_PORT, OUT_PC14_GPIO_PIN);//灭灯
//	  delay();//延时
//	  Usart_Sendbyte(COM_PORT,0x03);
//  }
//}
#include "ht32.h"
#include "ht32_board.h"
#include "GPIO.h"
#include "uart.h"
#include "key.h"

/**********************TH32 串口点灯**********************
Author:小殷

Date:2022-4-18
******************************************************/
uint8_t data = 0;		//串口数据
uint8_t key_stat = 0; //按键状态
int main()
{
	GPIOC14_Configuration();
	GPIOC15_Configuration();
	USARTx_Init();
	Key_Init();
	Usart_SendStr(COM1_PORT,(uint8_t *)"------HT32 UART TEST-------\r\n");//循环发送字符串，测试用
//	GPIO_SetOutBits(OUT_PC14_GPIO_PORT, OUT_PC14_GPIO_PIN);//灭灯
//	GPIO_SetOutBits(OUT_PC15_GPIO_PORT, OUT_PC15_GPIO_PIN);//灭灯
	while(1)
	{
		
	}
}



void COM_IRQHandler(void)
{
	u8 data;
	
	if( USART_GetFlagStatus(COM_PORT, USART_FLAG_RXDR) )
	{
		data = USART_ReceiveData(COM_PORT);
		
		
		if(data == '0')
		{
			GPIO_ClearOutBits(OUT_PC14_GPIO_PORT, OUT_PC14_GPIO_PIN);//亮灯
			printf("data = %c \r\n",data);
			printf("LED1 ON\r\n");
		}
		else if(data == '1')
		{
			GPIO_SetOutBits(OUT_PC14_GPIO_PORT, OUT_PC14_GPIO_PIN);//灭灯
			printf("data = %c \r\n",data);
			printf("LED1 OFF\r\n");
		}
		//EXTI_ClearEdgeFlag(EXTI_CHANNEL_2);
	}

}


void EXTI4_15_IRQHandler(void)
{	
    if(key_stat == 0)
		{
			key_stat = 1;
			GPIO_ClearOutBits(OUT_PC14_GPIO_PORT, OUT_PC14_GPIO_PIN);//亮灯
		}
		else if(key_stat == 1)
		{
			key_stat = 0;
			GPIO_SetOutBits(OUT_PC14_GPIO_PORT, OUT_PC14_GPIO_PIN);//灭灯
		}
		EXTI_ClearEdgeFlag(EXTI_CHANNEL_4);
}

void EXTI2_3_IRQHandler(void)
{
	 if(key_stat == 0)
		{
			key_stat = 1;
			GPIO_ClearOutBits(OUT_PC15_GPIO_PORT, OUT_PC15_GPIO_PIN);//亮灯
		}
		else if(key_stat == 1)
		{
			key_stat = 0;
			GPIO_SetOutBits(OUT_PC15_GPIO_PORT, OUT_PC15_GPIO_PIN);//灭灯
		}
		EXTI_ClearEdgeFlag(EXTI_CHANNEL_2);
}
