linqiugui/Wall-climbing-robot-graduation-project-/爬壁机器人/ht32学习/练习代码/htKEY中断/project/GPIO.c

//-----------------------------------------------------------------------------
#include "GPIO.h"

//-----------------------------------------------------------------------------
void GPIOC14_Configuration(void)
{
  CKCU_PeripClockConfig_TypeDef CKCUClock = {{ 0 }};
  CKCUClock.Bit.PC    = 1;
  CKCU_PeripClockConfig(CKCUClock, ENABLE);



  GPIO_ClearOutBits       (OUT_PC14_GPIO_PORT, OUT_PC14_GPIO_PIN);
  GPIO_DirectionConfig    (OUT_PC14_GPIO_PORT, OUT_PC14_GPIO_PIN, GPIO_DIR_OUT);
}

void GPIOC15_Configuration(void)
{
  CKCU_PeripClockConfig_TypeDef CKCUClock = {{ 0 }};
  CKCUClock.Bit.PC    = 1;
  CKCU_PeripClockConfig(CKCUClock, ENABLE);



  GPIO_ClearOutBits       (OUT_PC15_GPIO_PORT, OUT_PC15_GPIO_PIN);
  GPIO_DirectionConfig    (OUT_PC15_GPIO_PORT, OUT_PC15_GPIO_PIN, GPIO_DIR_OUT);
}
//-----------------------------------------------------------------------------
