linqiugui/Wall-climbing-robot-graduation-project-/爬壁机器人/ht32学习/练习代码/htKEY中断/project/MDK_ARMv5/UART.c

#include "uart.h"
 
static void USART0_CKCU_Config()
{
	CKCU_PeripClockConfig_TypeDef CCLOCK;
	
	CCLOCK.Bit.AFIO   = 1;
	CCLOCK.Bit.USART0 = 1;
	CCLOCK.Bit.PA			= 1;
	
	CKCU_PeripClockConfig(CCLOCK, ENABLE);
}
 
static void USART1_CKCU_Config()
{
	CKCU_PeripClockConfig_TypeDef CCLOCK;
	
	CCLOCK.Bit.AFIO   = 1;
	CCLOCK.Bit.USART1 = 1;
	CCLOCK.Bit.PA			= 1;
	
	CKCU_PeripClockConfig(CCLOCK, ENABLE);
} 
 
 
static void USART_AFIO_Config()
{
	AFIO_GPxConfig(COM_TX_GPIO_ID, COM_TX_AFIO_PIN, AFIO_FUN_USART_UART);
	AFIO_GPxConfig(COM_RX_GPIO_ID, COM_RX_AFIO_PIN, AFIO_FUN_USART_UART);
}
 
static void USARTx_Config()
{
	USART_InitTypeDef USART_InitStructure;
	
	/*USART初始化
	*波特率：115200
	*字节长度：8位
	*停止位：1位
	*校验位：无			
	*模式：正常模式
	**/
	USART_InitStructure.USART_BaudRate = 115200;
	USART_InitStructure.USART_WordLength = USART_WORDLENGTH_8B;
	USART_InitStructure.USART_StopBits = USART_STOPBITS_1;
	USART_InitStructure.USART_Parity = USART_PARITY_NO;
	USART_InitStructure.USART_Mode = USART_MODE_NORMAL;
	USART_Init(COM_PORT, &USART_InitStructure);
	
	/* 设置USART中断标志 */
	USART_IntConfig(COM_PORT, USART_INT_RXDR, ENABLE);
	/* 使能USART接收、发送 */
	USART_TxCmd(COM_PORT, ENABLE);
	USART_RxCmd(COM_PORT, ENABLE);
	/* 初始化中断 */
	NVIC_EnableIRQ(COM_IRQn);
	
}
 
//初始化函数
void USARTx_Init()
{
	USART0_CKCU_Config();
	USART1_CKCU_Config();
	USART_AFIO_Config();
	USARTx_Config();
}
 
// 发送一个字节
void Usart_Sendbyte(HT_USART_TypeDef* USARTx, u8 Data)
{
	USART_SendData(COM_PORT, Data);
	// 等待发送数据寄存器清空
	while (USART_GetFlagStatus(COM_PORT, USART_FLAG_TXDE) == RESET);		
}
 
//发送每个元素数据长度为8位的数组
void Usart_SendArray(HT_USART_TypeDef* USARTx, u8 *array,u8 num)
{
	u8 i;
	for( i = 0;i < num;i++)
	{
		Usart_Sendbyte(USARTx,*array);
		array++;
	}
}
 
// 发送字符串
void Usart_SendStr(HT_USART_TypeDef* USARTx, uint8_t *str)
{
	uint8_t i;
	for(i = 0;str[i] != '\0';i++)
	{
		Usart_Sendbyte(USARTx,str[i]);
	}
}
 
// 重定向c库函数printf到串口，重定向后可使用printf函数
int fputc(int ch, FILE *f)
{
	/* 发送一个字节数据到串口 */
	USART_SendData(COM_PORT, (uint8_t) ch);
		
	/* 等待发送完毕 */
	while (USART_GetFlagStatus(COM_PORT, USART_FLAG_TXDE) == RESET);		
	
	return (ch);
}
 
// 重定向c库函数scanf到串口，重写向后可使用scanf、getchar等函数
int fgetc(FILE *f)
{
	/* 等待串口输入数据 */
	while (USART_GetFlagStatus(COM_PORT, USART_FLAG_RXDNE) == RESET);
 
	return (int)USART_ReceiveData(COM_PORT);
}
 
///*中断函数*/

//void COM_IRQHandler(void)
//{
//	u8 data;
//	
//	if( USART_GetFlagStatus(COM_PORT, USART_FLAG_RXDR) )//接收中断
//	{
//		data = USART_ReceiveData(COM_PORT); //读取接收到的数据
//		printf("data = %c\n",data);
//		
//	}
//	EXTI_ClearEdgeFlag(EXTI_CHANNEL_2);
//}
