linqiugui/Wall-climbing-robot-graduation-project-/爬壁机器人/ht32学习/练习代码/htLED 驱动4路舵机/project/time.h

#include "ht32f5xxxx_bftm.h"

#define HTGPIO_PIN (GPIO_PIN_4|GPIO_PIN_5|GPIO_PIN_6|GPIO_PIN_7)


void GPTM_PWM_init(void);
void Servo_Run(uint16_t angle);
void Servo_Run2(uint16_t angle);
void Servo_Run3(uint16_t angle);
void Servo_Run4(uint16_t angle);
