linqiugui/Wall-climbing-robot-graduation-project-/爬壁机器人/ht32学习/练习代码/htTIMER点灯/project/timer.c

#include "time.h"
#include "GPIO.h"
#include "uart.h"



void Timer_Init(void)
{	
	CKCU_PeripClockConfig_TypeDef CKCUClock= {{0}};
	CKCUClock.Bit.BFTM1 = 1;  //开启中断时钟
	CKCU_PeripClockConfig(CKCUClock, ENABLE);
	
	NVIC_EnableIRQ(BFTM1_IRQn);
	
	BFTM_SetCounter(HT_BFTM1, 0);
	//BFTM_SetCompare(HT_BFTM1, SystemCoreClock);//定时1s产生中断
	BFTM_SetCompare(HT_BFTM1, SystemCoreClock/1000);//定时1ms产生中断
	BFTM_IntConfig(HT_BFTM1, ENABLE);//使能中断
	BFTM_EnaCmd(HT_BFTM1, ENABLE);//使能BFTM
}
